nkalan/eecs430-phased-array/EECS430W24_Group7_PCB_BOM.xlsx

Sheet: Full BOM
PN | Description | Designator | Quantity | Manufacturer | Supplier/Source | Link | Unit Cost | Line Cost | Populated
5000 | Red PC Test Point, Miniature Phosphor Bronze Silver Plating Through Hole Mounting Type | TP6, TP7, TP8, TP9, TP10, TP11, TP12, TP13, TP14, TP15, TP16, TP17, TP18 | 13 | Keystone Electronics | Digikey | https://www.digikey.com/en/products/detail/keystone-electronics/5000/255326 | $0.38 | $4.94
OSTVN02A150 | 2 Position Wire to Board Terminal Block Horizontal with Board 0.100" (2.54mm) Through Hole | J3 | 1 | On Shore | Digikey | https://www.digikey.com/en/products/detail/on-shore-technology-inc/OSTVN02A150/1588862 | $1.08 | $1.08
OSTVN03A150 | 3 Position Wire to Board Terminal Block Horizontal with Board 0.100" (2.54mm) Through Hole | J5, J6 | 2 | On Shore | Digikey | https://www.digikey.com/en/products/detail/on-shore-technology-inc/OSTVN03A150/1588863 | $1.23 | $2.46
0732511153 | SMA Connector Jack, Female Socket 50 Ohms Board Edge, End Launch Solder | J1, J2 | 3 | Molex | Digikey | https://www.digikey.com/en/products/detail/molex/0732511153/11305709?s=N4IgTCBcDaIOwGYwFYCM7kJAXQL5A | $3.99 | $11.97
Adafruit_1993 | 2x20 pin Male IDC Box Header - Raspberry Pi A+/B+/Pi 2/Pi 3/Pi 4 | J4 | 1 | Adafruit | Mouser | https://www.mouser.com/ProductDetail/Adafruit/1993?qs=GURawfaeGuBf53f02YlWog%3D%3D | $0.75 | $0.75
Adafruit_1988 | Raspberry Pi Accessories GPIO Ribbon Cable for Raspberry Pi Model A+/B+/Pi 2/Pi 3/Pi 4/5 - (40 pins) | P4 | 1 | Adafruit | Mouser | https://www.mouser.com/ProductDetail/Adafruit/1988?qs=GURawfaeGuA61sDlPzRlbQ%3D%3D | $2.95 | $2.95
APG1005CGC-T | LED GREEN CLEAR CHIP SMD | D1, D2, D3 | 3 | Kingbright | Digikey | https://www.digikey.com/en/products/detail/kingbright/apg1005cgc-t/4764964 | $0.39 | $1.17
n/a | DNP | D4 | 1 | n/a | n/a | n/a | $0.00 | $0.00
KGM15BR71H104KT | 0.1 µF ±10% 50V Ceramic Capacitor X7R 0603 (1608 Metric) | C2, C4, C20 | 3 | Samsung | Digikey | https://www.digikey.com/en/products/detail/kyocera-avx/KGM15BR71H104KT/1600046 | $0.10 | $0.30
CL21B105KBFNNNE | 1 µF ±10% 50V Ceramic Capacitor X7R 0805 (2012 Metric) | C1, C3, C19 | 3 | Samsung | Digikey | https://www.digikey.com/en/products/detail/samsung-electro-mechanics/CL21B105KBFNNNE/3886687 | $0.11 | $0.33
CL31A106KBHNNNE | 10 µF ±10% 50V Ceramic Capacitor X5R 1206 (3216 Metric) | C5 | 1 | Samsung | Digikey | https://www.digikey.com/en/products/detail/samsung-electro-mechanics/cl31a106kbhnnne/3888534 | $0.33 | $0.33
CL-SB-12C-01 | Slide Switch SPDT Through Hole | SW1, SW2 | 2 | Nidec Copal | Digikey | https://www.digikey.com/en/products/detail/nidec-components-corporation/cl-sb-12c-01/3507831 | $1.18 | $2.36
GRM188R72E331KW07D | 330 pF ±10% 250V Ceramic Capacitor X7R 0603 (1608 Metric) | C10, C11, C12 | 3 | Murata | Digikey | https://www.digikey.com/en/products/detail/murata-electronics/grm188r72e331kw07d/789370 | $0.90 | $2.70
GRM1555C1H101JA01 | 100 pF ±5% 50V Ceramic Capacitor C0G, NP0 0402 (1005 Metric) | C6 | 1 | Murata | Digikey | https://www.digikey.com/en/products/detail/murata-electronics/grm1555c1h101ja01d/3693829 | $0.10 | $0.10
GRM155R71H104KE14D | 100nF X7R 0402 ceramic bypass cap | C13.1, C13.2, C14.1, C14.2, C17.1, C17.2, C18.1, C18.2 | 8 | Murata | Digikey | https://www.digikey.com/en/products/detail/murata-electronics/GRM155R71H104KE14D/4906220 | $0.10 | $0.80
GRM1555C1H220JA01 | 22 pF ±5% 50V Ceramic Capacitor C0G, NP0 0402 (1005 Metric) | C7, C8, C15, C16 | 4 | Murata | Digikey | https://www.digikey.com/en/products/detail/murata-electronics/grm1555c1h220ja01d/3175187 | $0.10 | $0.40
HMC407MS8GETR | RF Amplifier IC General Purpose 5GHz ~ 7GHz 8-MSOP-EP | U2 | 1 | Analog Devices | Digikey | https://www.digikey.com/en/products/detail/analog-devices-inc/hmc407ms8getr/3452254 | $18.60 | $18.60
LQG15HS10NJ02D | Multilayer type RF Inductor 10nH ±5% 0.26Ω 500mA 0402 | L1 | 1 | Murata | Digikey | https://www.digikey.com/en/products/detail/murata-electronics/lqg15hs10nj02d/662872 | $0.10 | $0.10
MAPS-010145-TR0500 | Phase Detectors / Shifters 3.5-6.0GHz 4-Bit Step 22.5 deg. | U3.1, U3.2, U5.1, U5.2 | 4 | MACOM | Digikey | https://www.digikey.com/en/products/detail/macom-technology-solutions/MAPS-010145-TR0500/4429760 | $38.70 | $154.80
PE42423B-Z | RF Switch IC 802.11a/b/g/n/ac SPDT 6 GHz 50Ohm 16-QFN (3x3) | U4 | 1 | pSemi | Mouser | https://www.mouser.com/ProductDetail/pSemi/PE42423B-Z?qs=Cb2nCFKsA8oZ1mNDB1JweA%3D%3D | $2.35 | $2.35
PMA3-63GLN+ | RF Amplifier IC LTE, Radar, SATCOM, UMTS, WiFi, WiMAX, WLAN 1.8GHz ~ 6GHz 12-MCLP (3x3) | U1 | 1 | Mini-Circuits | Digikey | https://www.digikey.com/en/products/detail/mini-circuits/pma3-63gln/13927358 | $5.25 | $5.25
RC0603FR-0710KL | 10 kOhms ±1% 0.1W, 1/10W Chip Resistor 0603 (1608 Metric) Moisture Resistant Thick Film | R1, R5 | 2 | Yageo | Digikey | https://www.digikey.com/en/products/detail/yageo/RC0603FR-0710KL/726880 | $0.10 | $0.20
RC0603JR-070RL | 0 Ohms Jumper Chip Resistor 0603 (1608 Metric) Moisture Resistant Thick Film | R2, R3 | 2 | Yageo | Digikey | https://www.digikey.com/en/products/detail/yageo/RC0603JR-070RL/726675 | $0.10 | $0.20
RC0603JR-0722KL | 22 kOhms ±5% 0.1W, 1/10W Chip Resistor 0603 (1608 Metric) Moisture Resistant Thick Film | R4, R6 | 2 | Yageo | Digikey | https://www.digikey.com/en/products/detail/yageo/RC0603JR-0722KL/726744 | $0.10 | $0.20
RC0603JR-07150RL | 150 Ohms ±5% 0.1W, 1/10W Chip Resistor 0603 (1608 Metric) Moisture Resistant Thick Film | R7, R8, R9 | 3 | Yageo | Digikey | https://www.digikey.com/en/products/detail/yageo/RC0603JR-07150RL/726714 | $0.10 | $0.30
n/a | DNP | R10 | 1 | n/a | n/a | n/a | $0.00 | $0.00
TAJA225K016TNJ | 2.2 µF Molded Tantalum Capacitors 16 V 1206 (3216 Metric) 6.5Ohm @ 100kHz | C9 | 1 | Kyocera AVX | Digikey | https://www.digikey.com/en/products/detail/kyocera-avx/taja225k016tnj/11201938 | $0.38 | $0.38
 |  |  |  |  |  |  | Total | $215.02
 |  |  |  |  |  |  | Per array | $208.08

Sheet: Condensed BOM
Component | Cost
SMA Connectors | $11.97
Power Connectors | $3.54
Raspberry PI Connectors | $3.70
Power Amplifier | $18.60
Phase Shifters | $153.16
RF Switch | $2.35
Low Noise Amplifier | $5.25
Miscellaneous Passive Components | $19.00
Total | $217.57
Item | Cost
Components
