nkalan/eecs430-phased-array/EECS430PhasedArray_SCH_PRINT.pdf

# Phase Shifters

# USRP Interface

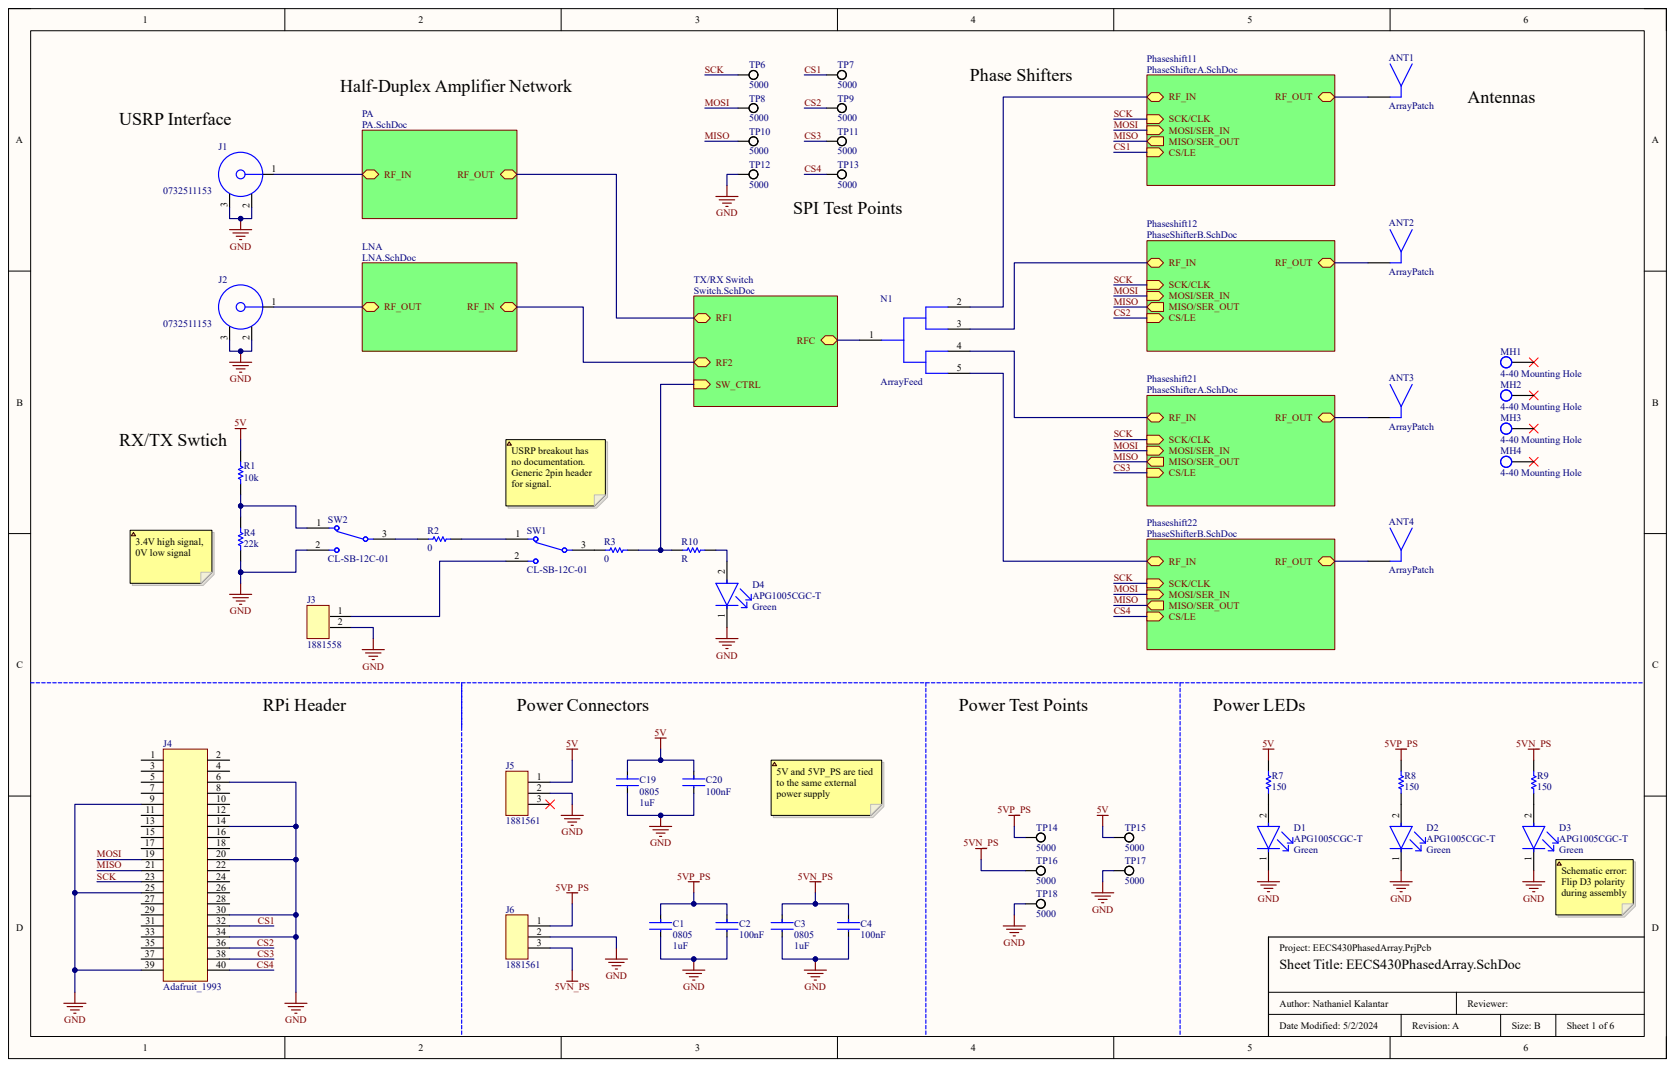
[picture p1: page 1]

Half-Duplex Amplifier Network

5V and 5VP_PS are tied
to the same external
power supply

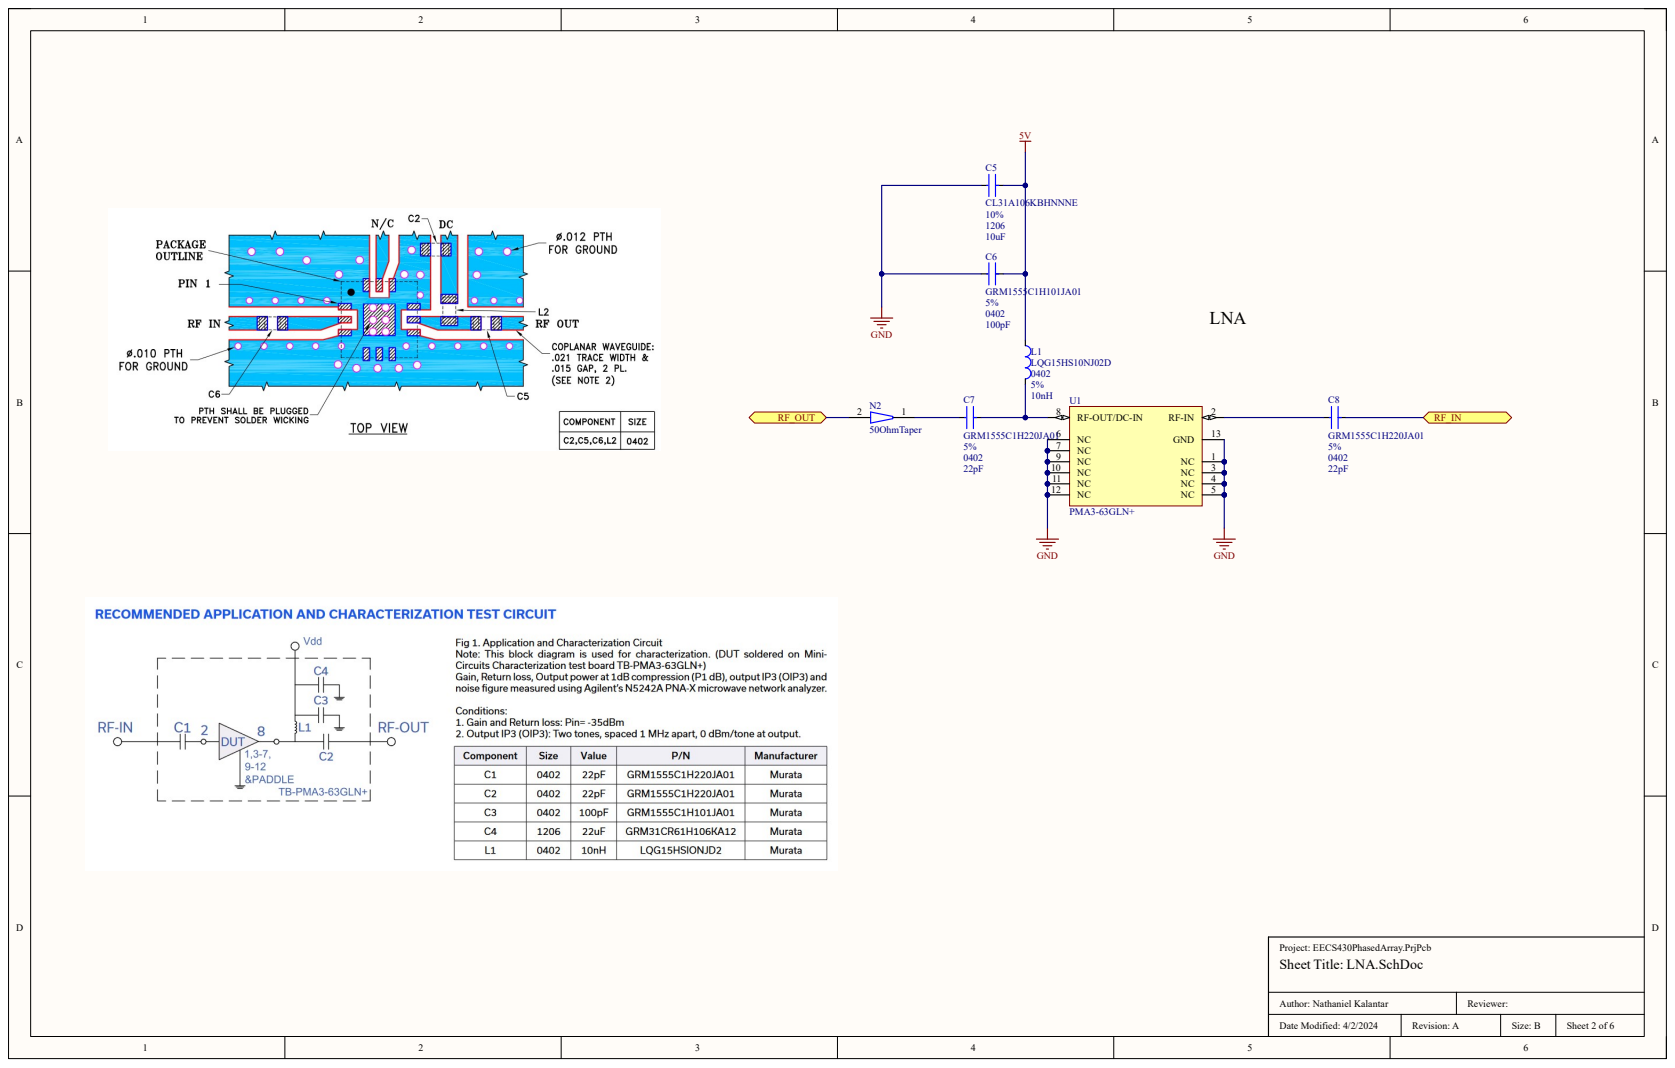
[picture p2: page 2]
Revision: A; Size: B; Sheet 2 of 6; Date Modified: 4/2/2024; GRM1555C1H220JA01; GRM1555C1H101JA01; CL31A106KBHNNNE; RF-OUT/DC-IN 8; GND; PMA3-63GLN+; L1 LQG15HS10NJ02D; LNA; RF_OUT; 50OhmTaper

Project: EECS430PhasedArray.PrjPcb
Sheet Title: LNA.SchDoc

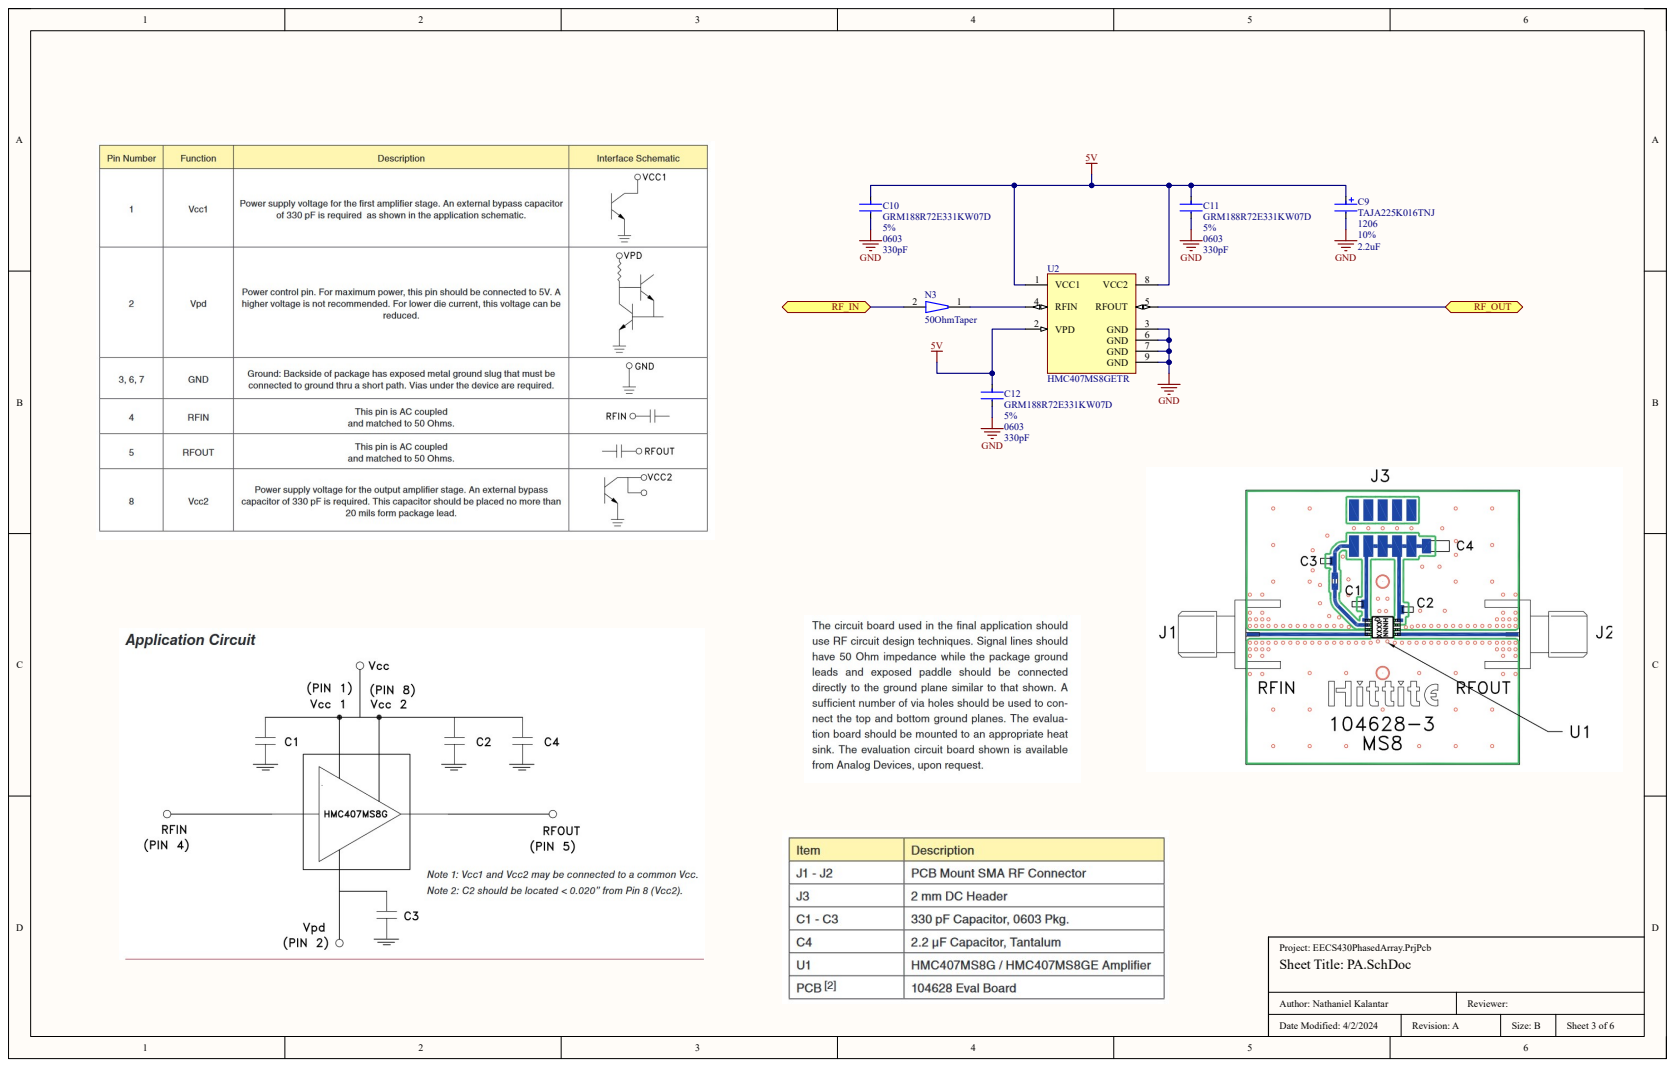
[picture p3: page 3]
Revision: A; Size: B; Sheet 3 of 6; RF_OUT 2; 50OhmTaper; C9 TAJA225K016TNJ; C10 GRM188R72E331KW07D; C11 GRM188R72E331KW07D; C12 GRM188R72E331KW07D; GND; VCC1 1; VPD 2; RFIN 4; RFOUT; VCC2; HMC407MS8GETR

Project: EECS430PhasedArray.PrjPcb
Sheet Title: PA.SchDoc

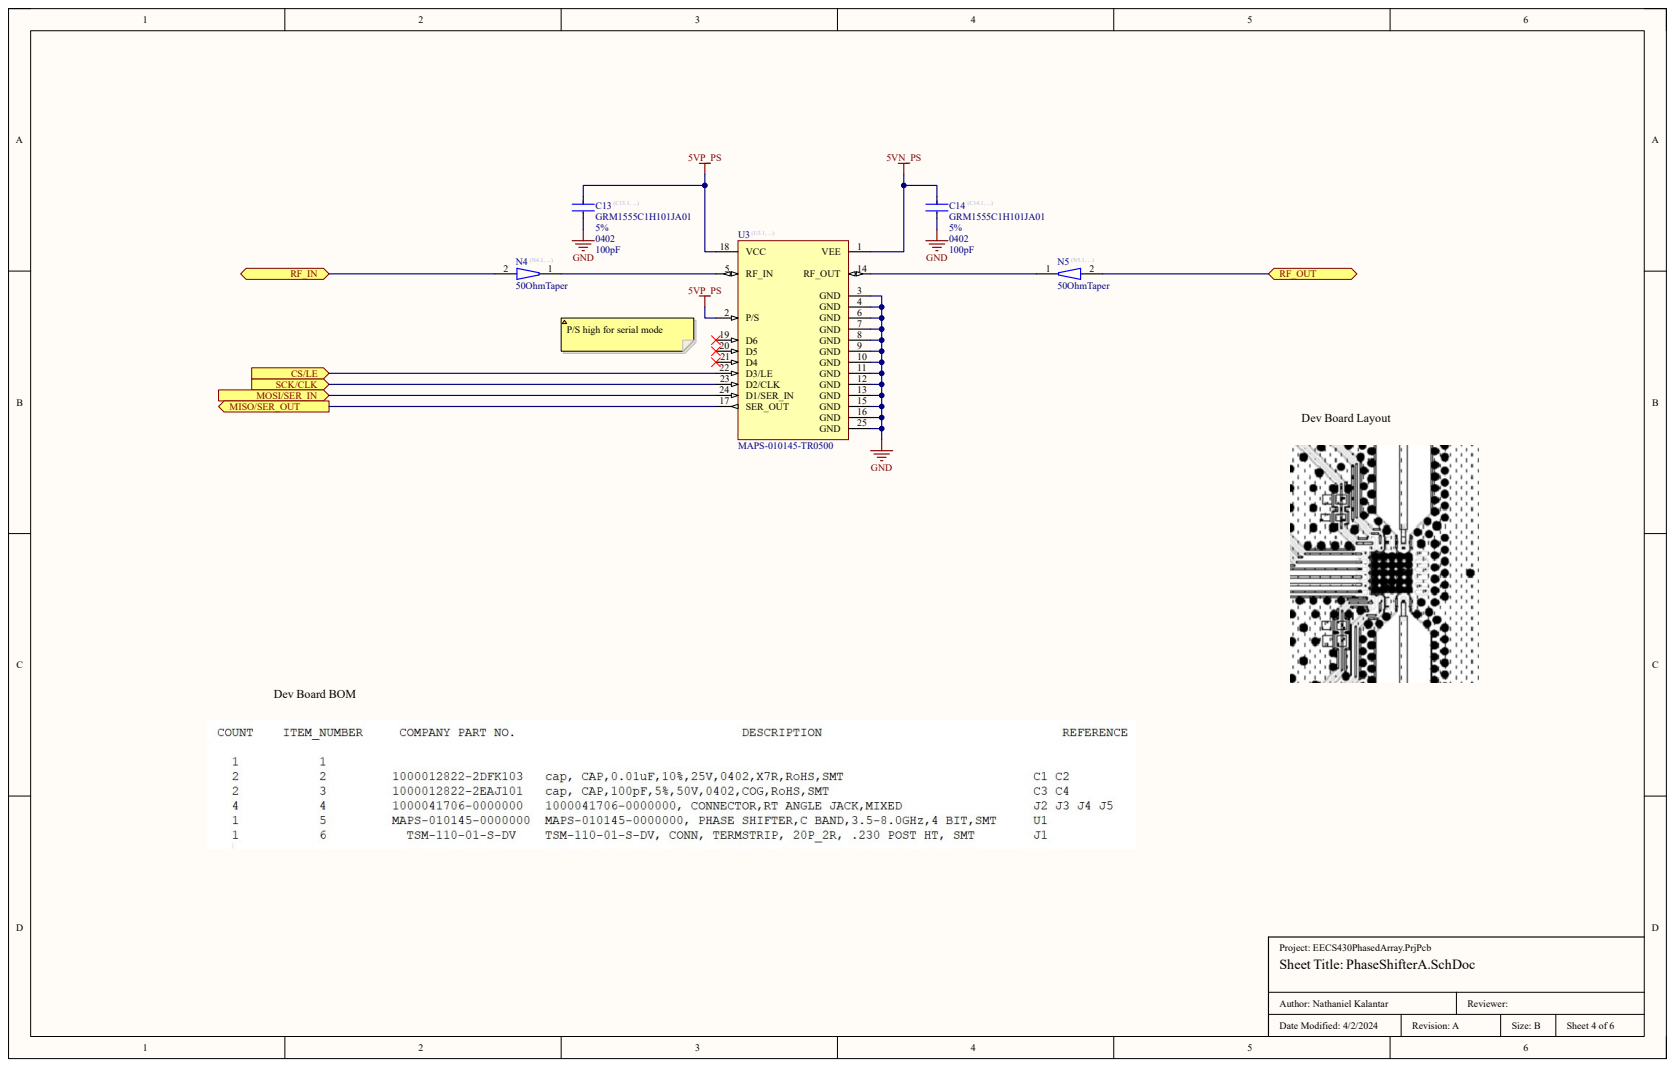
[picture p4: page 4]
Revision: A; Size: B; Sheet 4 of 6; VEE; 1 VCC 18; GND; RF_OUT; SER_OUT 17; D6 19 D5 20 D4 21 D3/LE 22 D2/CLK 23 D1/SER_IN 24; MAPS-010145-TR0500; C14 ⁽C14.1, ...) GRM1555C1H101JA01; C13 ⁽C13.1, ...) GRM1555C1H101JA01; SCK/CLK MOSI/SER_IN MISO/SER_OUT; RF_OUT 2; 50OhmTaper

P/S high for serial mode

Dev Board Layout

Dev Board BOM

Project: EECS430PhasedArray.PrjPcb
Sheet Title: PhaseShifterA.SchDoc

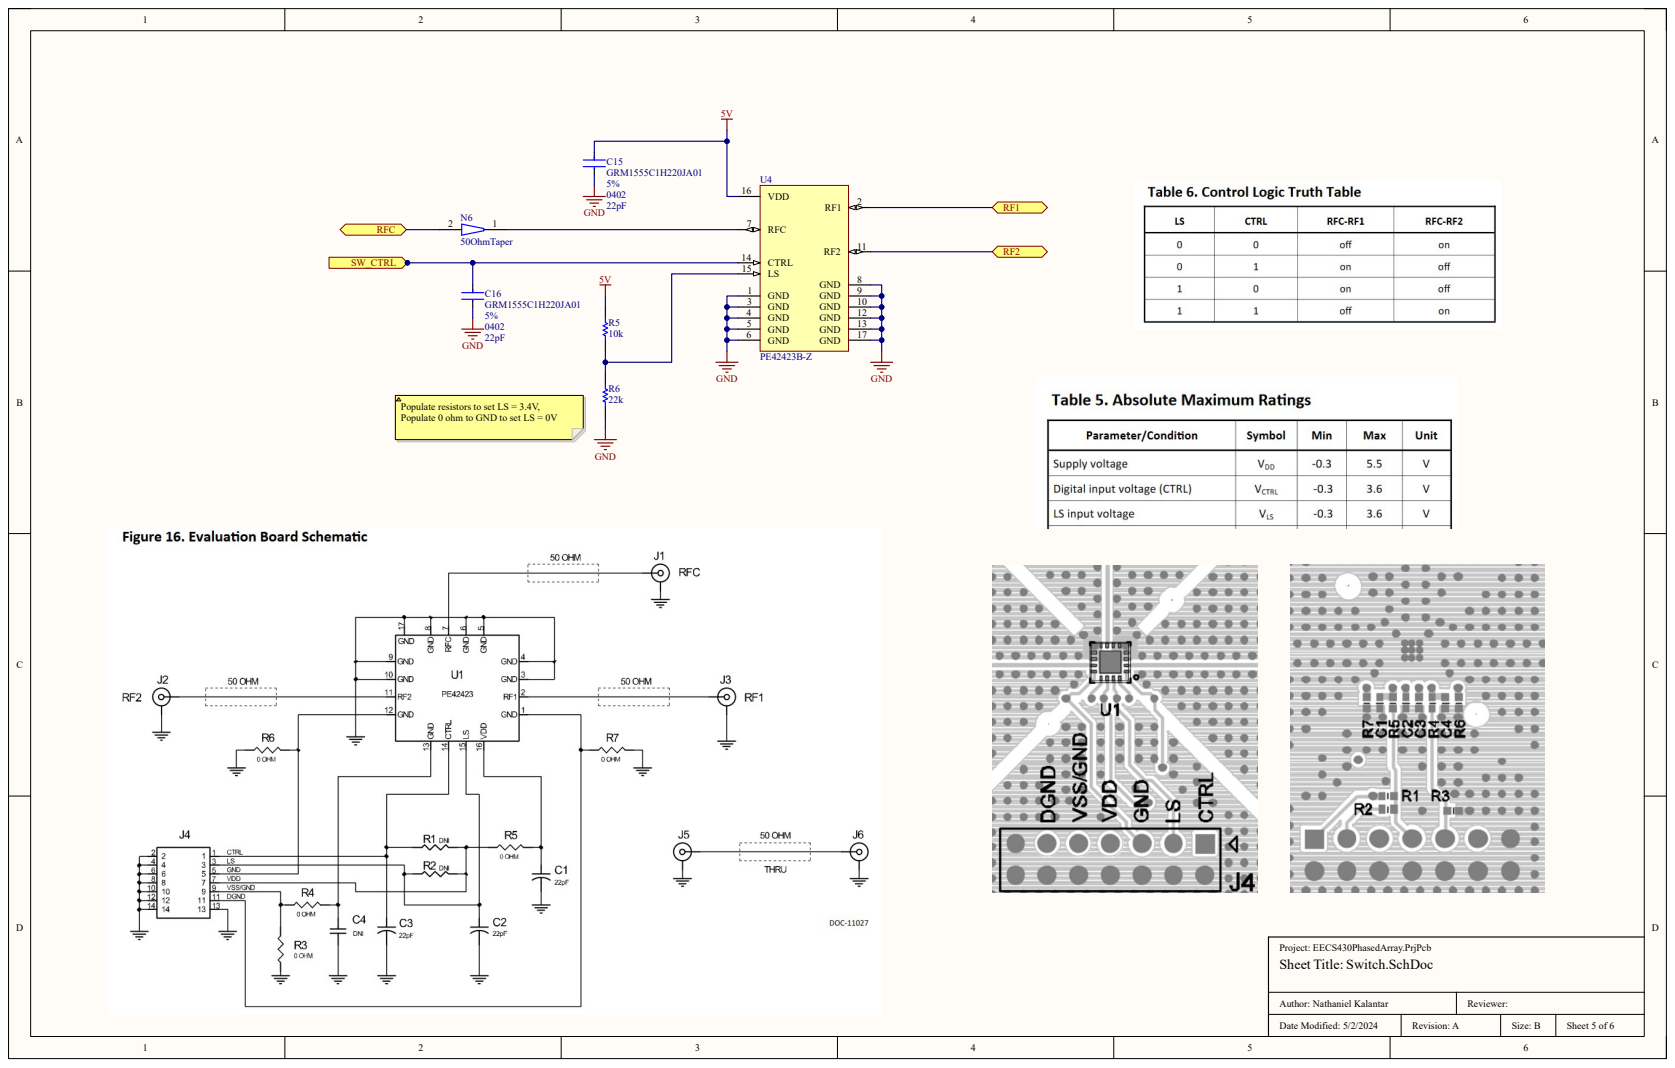
[picture p5: page 5]
Revision: A; Size: B; Sheet 5 of 6; Date Modified: 5/2/2024; GND 1 GND 3 GND 4 GND 5 GND 6; GND; RFC 7; CTRL 14 LS 15; VDD 16; C16 GRM1555C1H220JA01; C15 GRM1555C1H220JA01; RFC; SW_CTRL; 50OhmTaper

Populate resistors to set LS = 3.4V,
Populate 0 ohm to GND to set LS = 0V

Project: EECS430PhasedArray.PrjPcb
Sheet Title: Switch.SchDoc

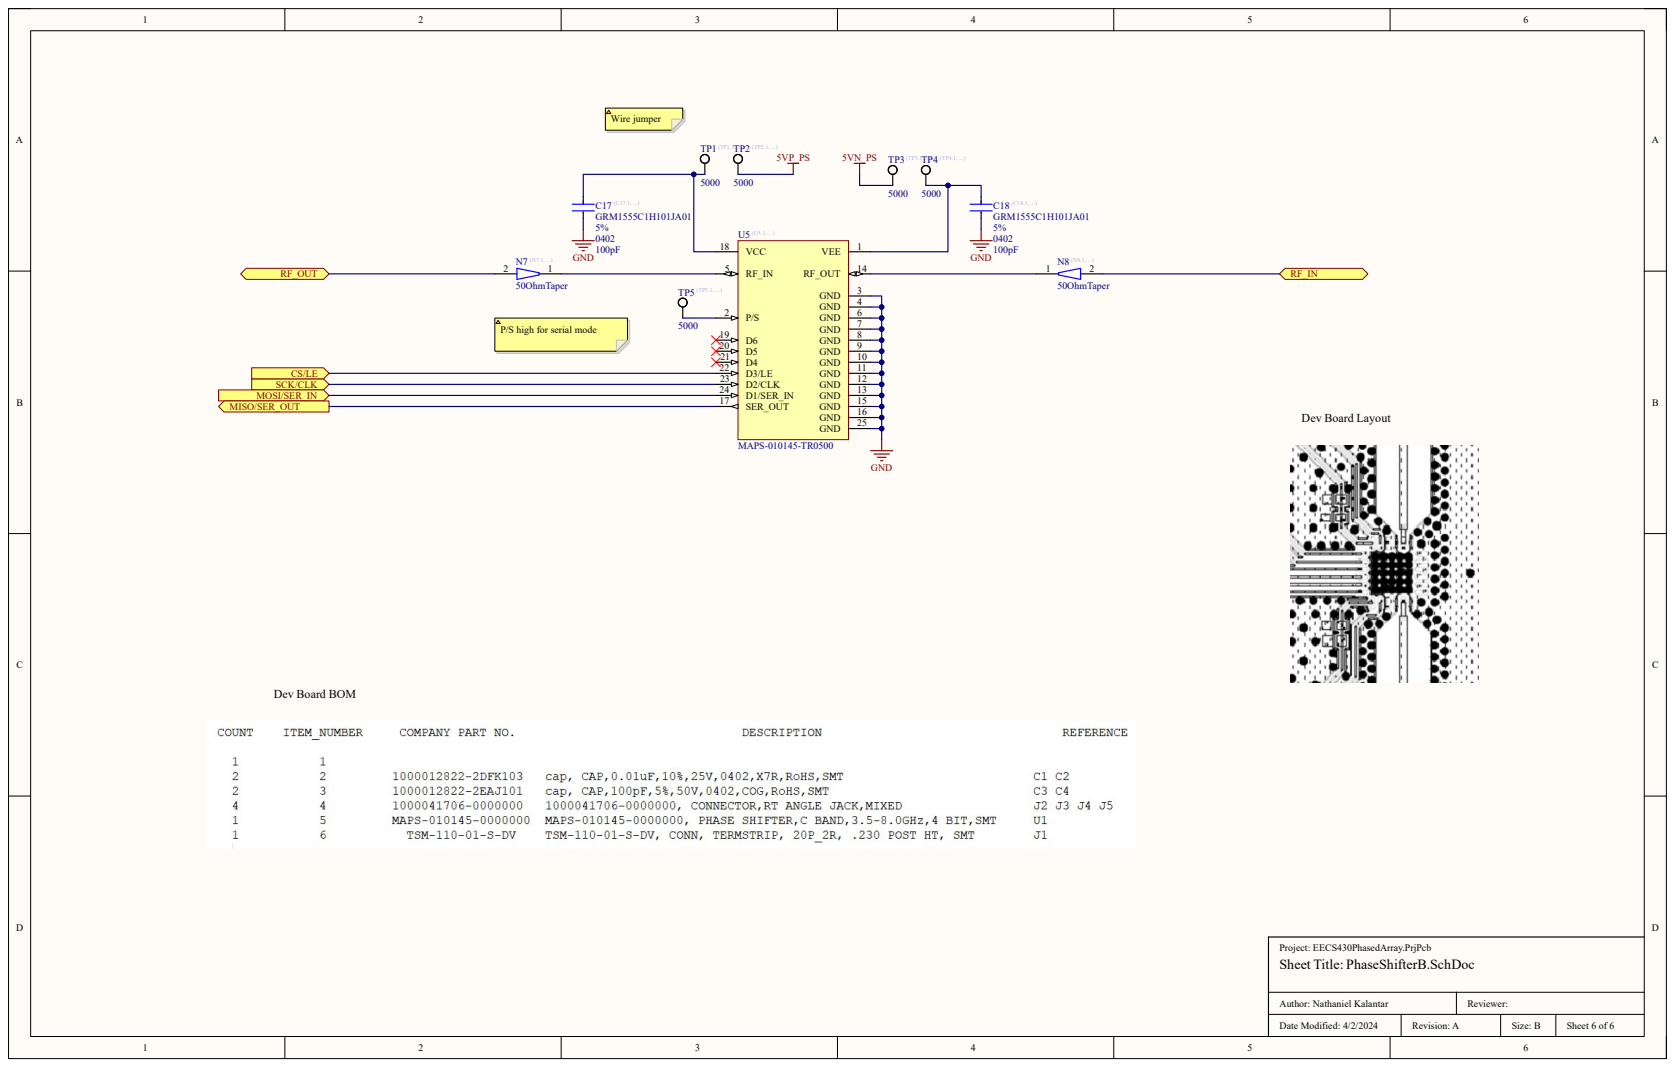
[picture p6: page 6]

5000 P/S high for serial mode

Project: EECS430PhasedArray.PrjPcb
Sheet Title: PhaseShifterB.SchDoc
