nkalan/eecs430-phased-array/EECS430SinglePatch_SCH_PRINT.pdf

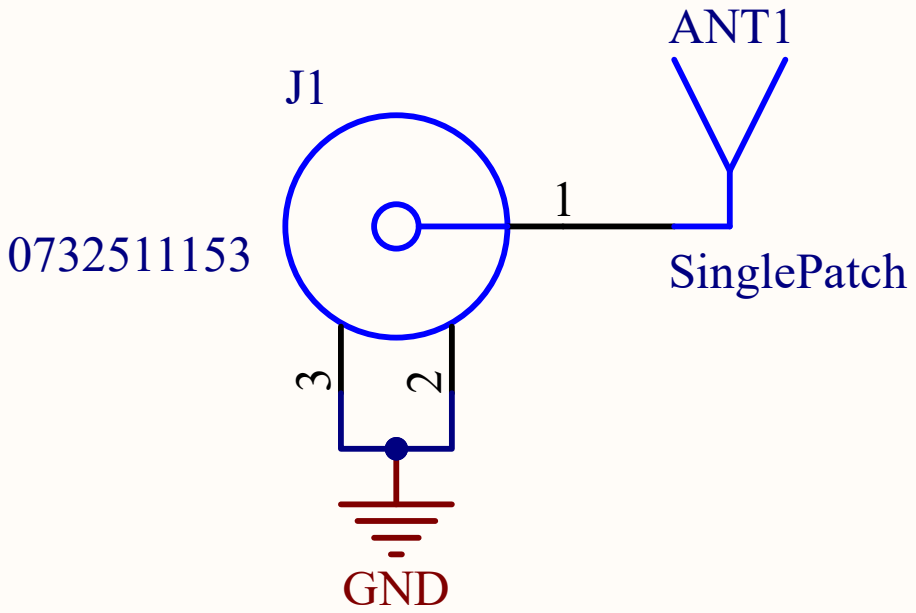
[picture p7: page 1]
Revision:; Size: B; Sheet 1 of 1; Date Modified: 5/2/2024; Author:; Reviewer:; ANT1; SinglePatch; GND

Project: EECS430SinglePatch.PrjPcb
Sheet Title: EECS430SinglePatch.SchDoc
