nkalan/eecs430-phased-array/EECS430PhasedArray/2024-03-25 Schematic Preliminary Printout.pdf

# Phase Shifters USRP Interface

# Half-Duplex Amplifier Network

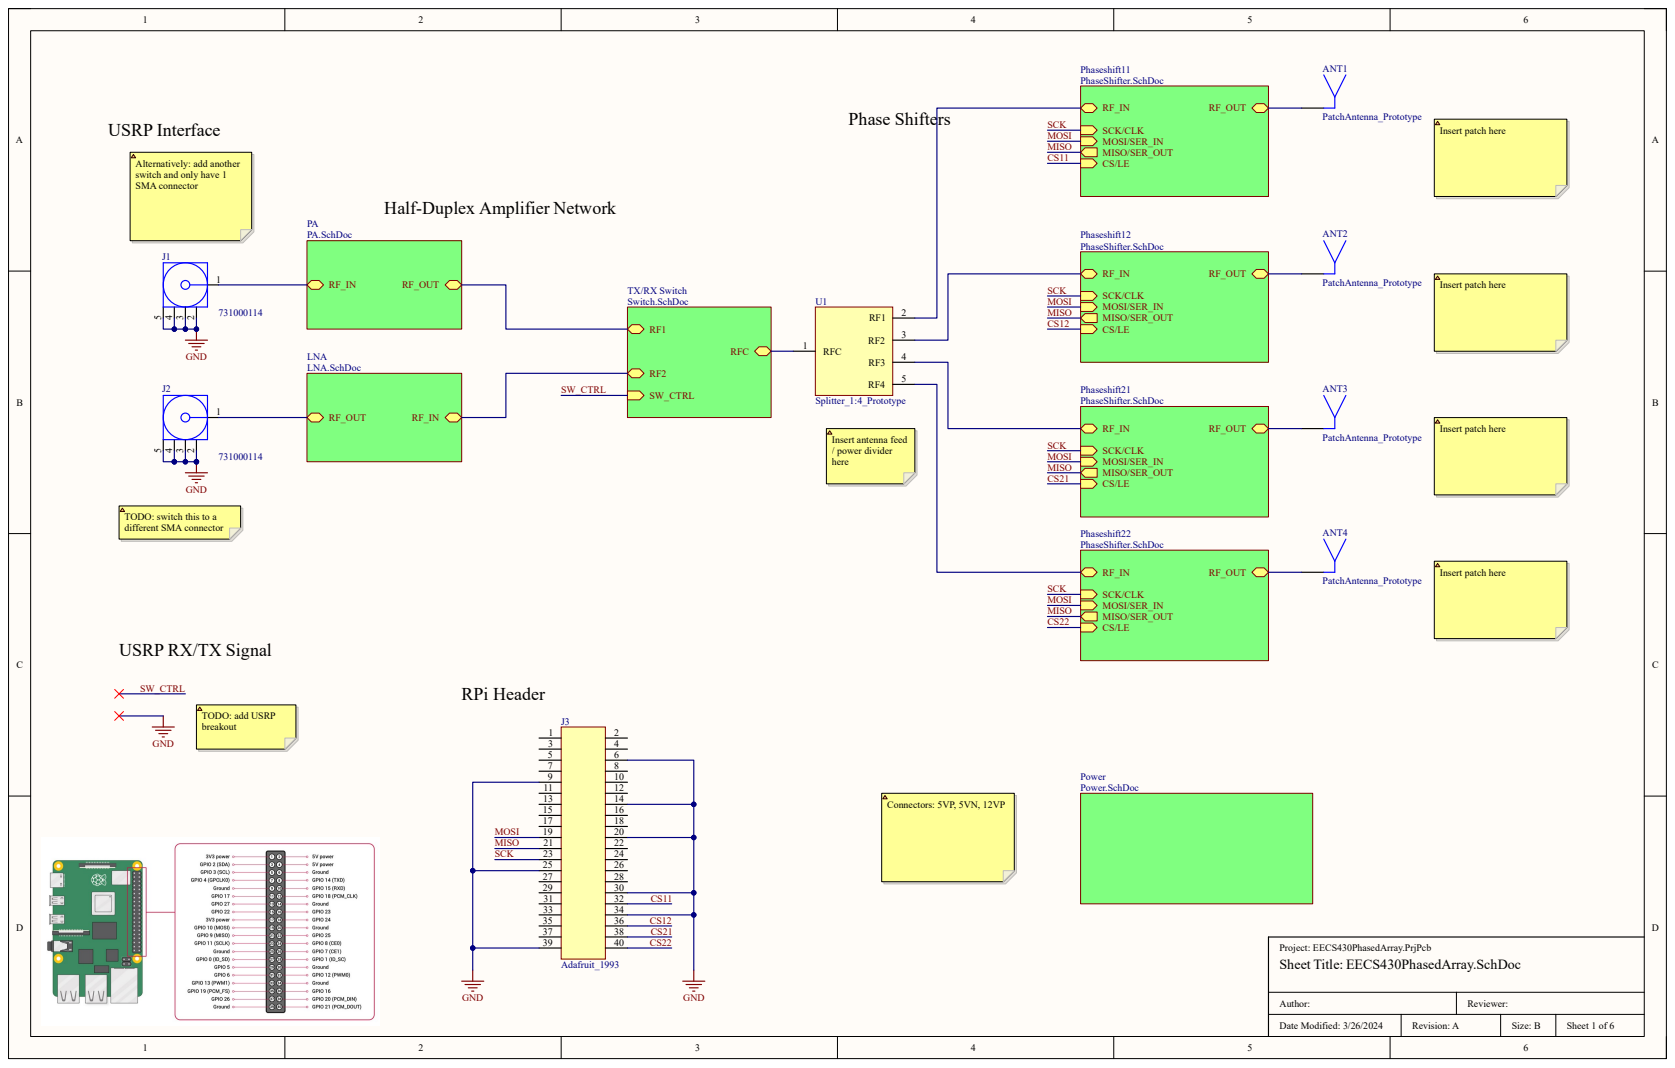
[picture p8: page 1]
Revision: A; Size: B; Sheet 1 of 6; Date Modified: 3/26/2024; Author:; Reviewer:; RF_OUT; LNA LNA.SchDoc; PA PA.SchDoc; RFC; SW_CTRL; SCK/CLK MOSI/SER_IN MISO/SER_OUT CS/LE; Phaseshift11 PhaseShifter.SchDoc; Phaseshift12 PhaseShifter.SchDoc; Phaseshift21 PhaseShifter.SchDoc; Phaseshift22 PhaseShifter.SchDoc; GND; Adafruit_1993; SCK; SCK MOSI; MOSI; MISO; MISO CS11; MOSI MISO; RPi Header; Power Power.SchDoc; RFC 1; Splitter_1:4_Prototype; ANT1; PatchAntenna_Prototype; ANT2; ANT3; ANT4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

Insert patch here

Alternatively: add another
switch and only have 1
SMA connector

TX/RX Switch
Switch.SchDoc

Insert antenna feed
/ power divider
here

TODO: switch this to a
different SMA connector

USRP RX/TX Signal

TODO: add USRP
breakout

Project: EECS430PhasedArray.PrjPcb
Sheet Title: EECS430PhasedArray.SchDoc

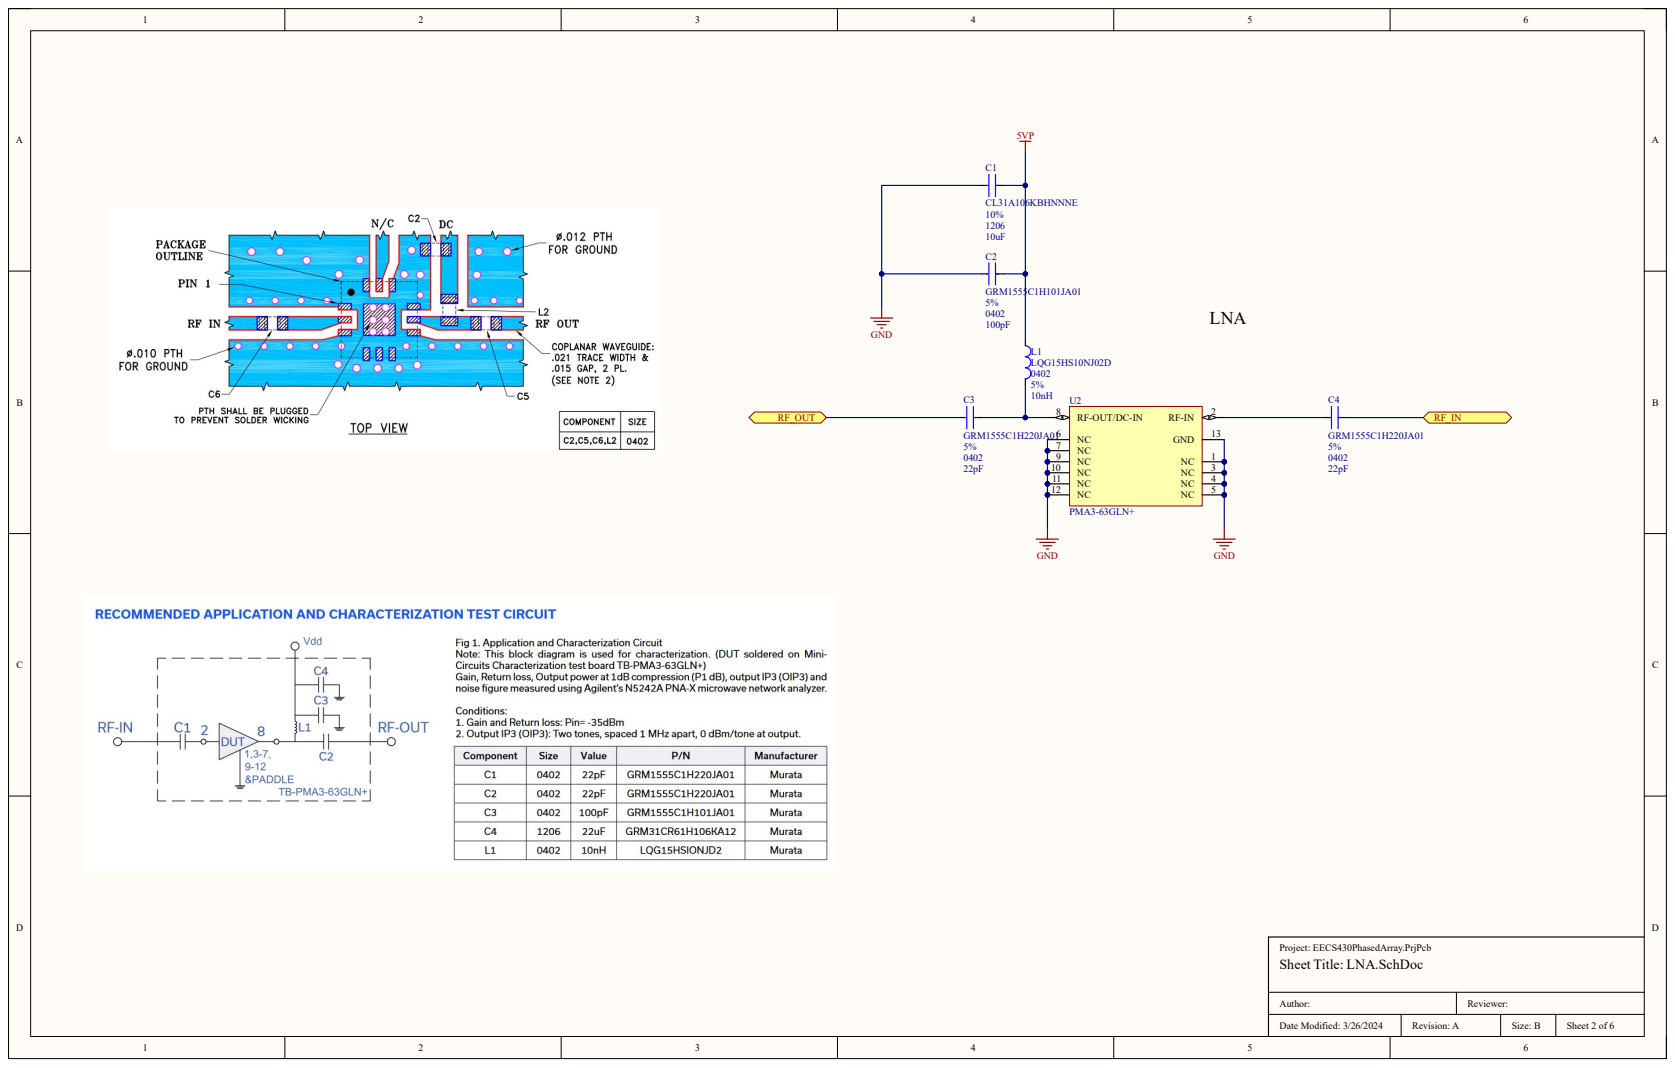
[picture p9: page 2]
Revision: A; Size: B; Sheet 2 of 6; GRM1555C1H220JA01; GRM1555C1H101JA01; CL31A106KBHNNNE; RF-OUT/DC-IN 8; GND; PMA3-63GLN+; L1 LQG15HS10NJ02D; LNA; RF_OUT

Project: EECS430PhasedArray.PrjPcb
Sheet Title: LNA.SchDoc

PA

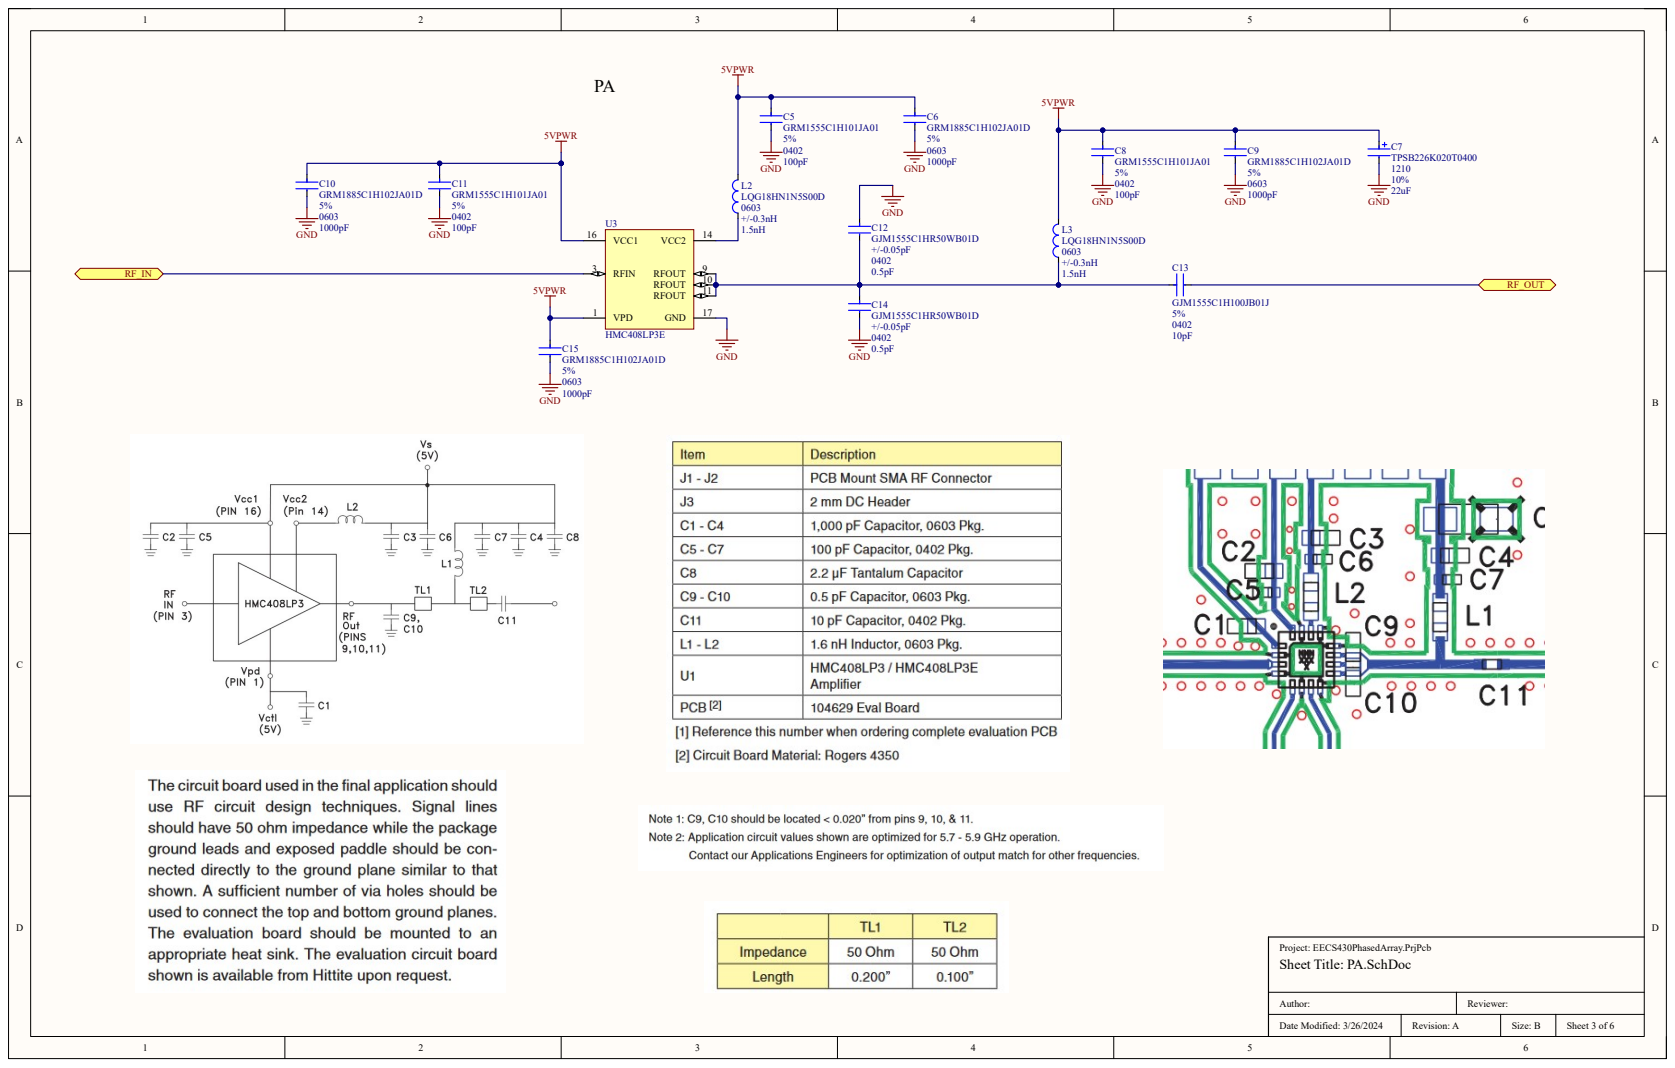
[picture p10: page 3]

Project: EECS430PhasedArray.PrjPcb
Sheet Title: PA.SchDoc

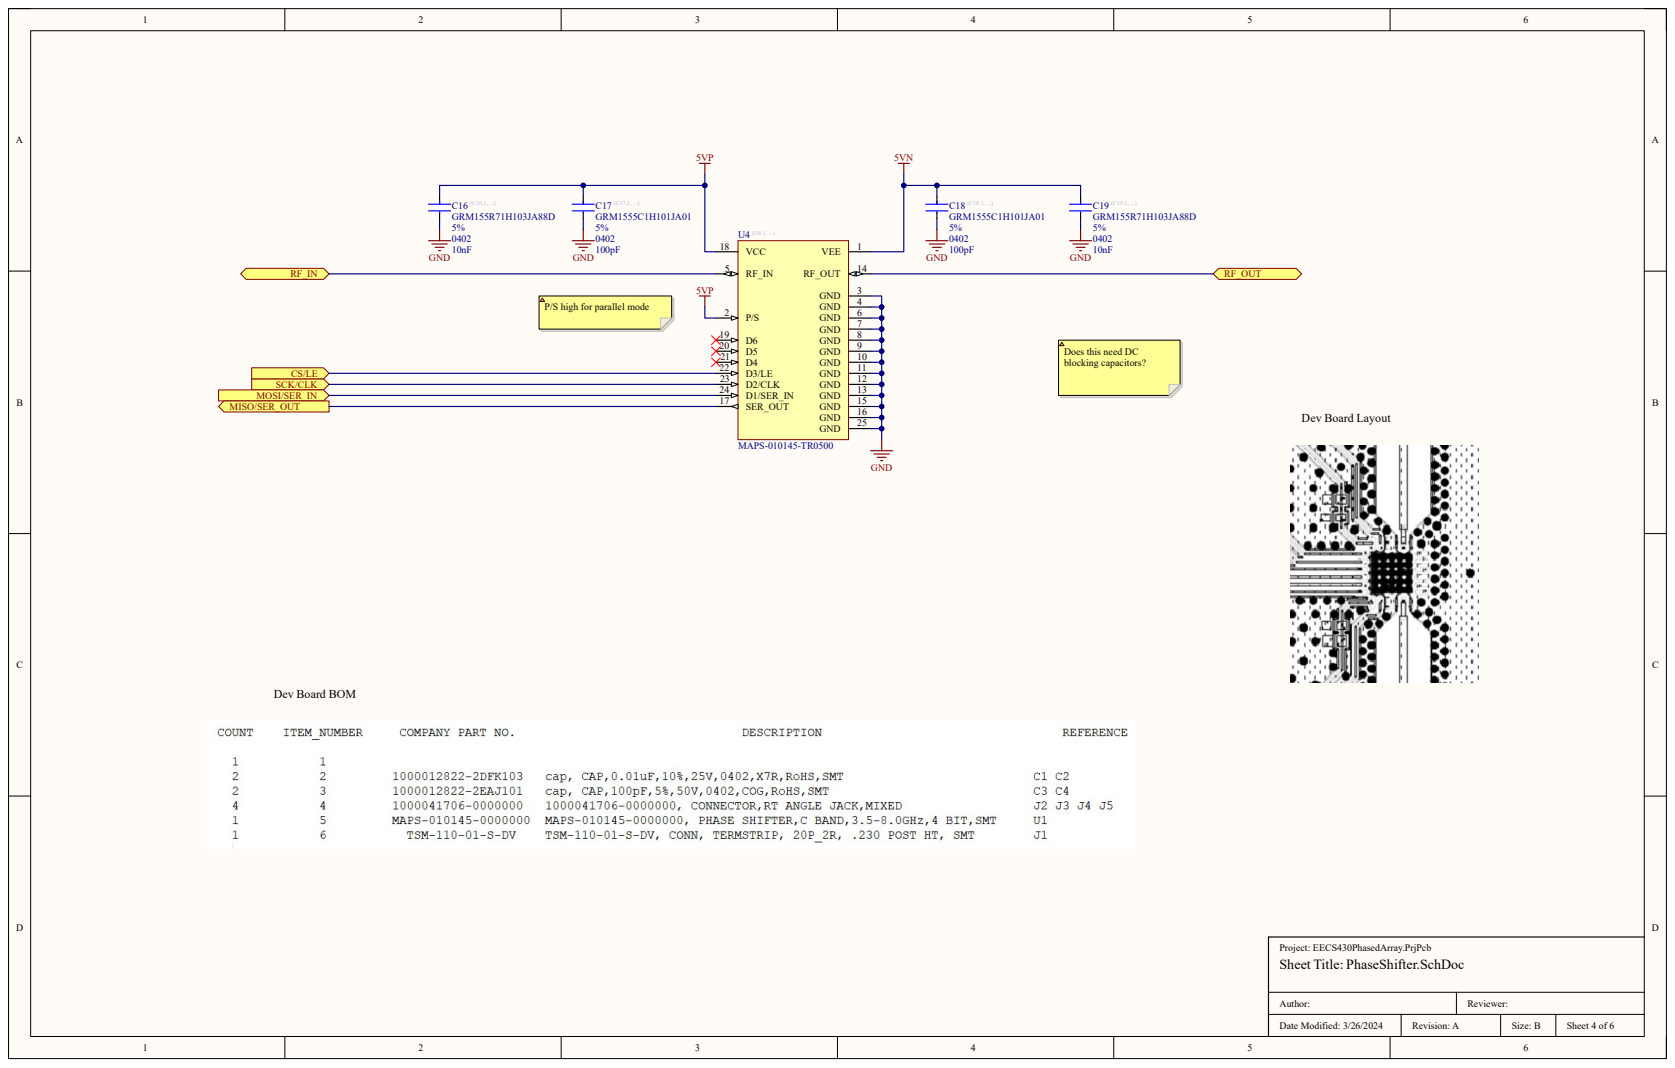
[picture p11: page 4]

P/S high for parallel mode

Does this need DC
blocking capacitors?

Project: EECS430PhasedArray.PrjPcb
Sheet Title: PhaseShifter.SchDoc

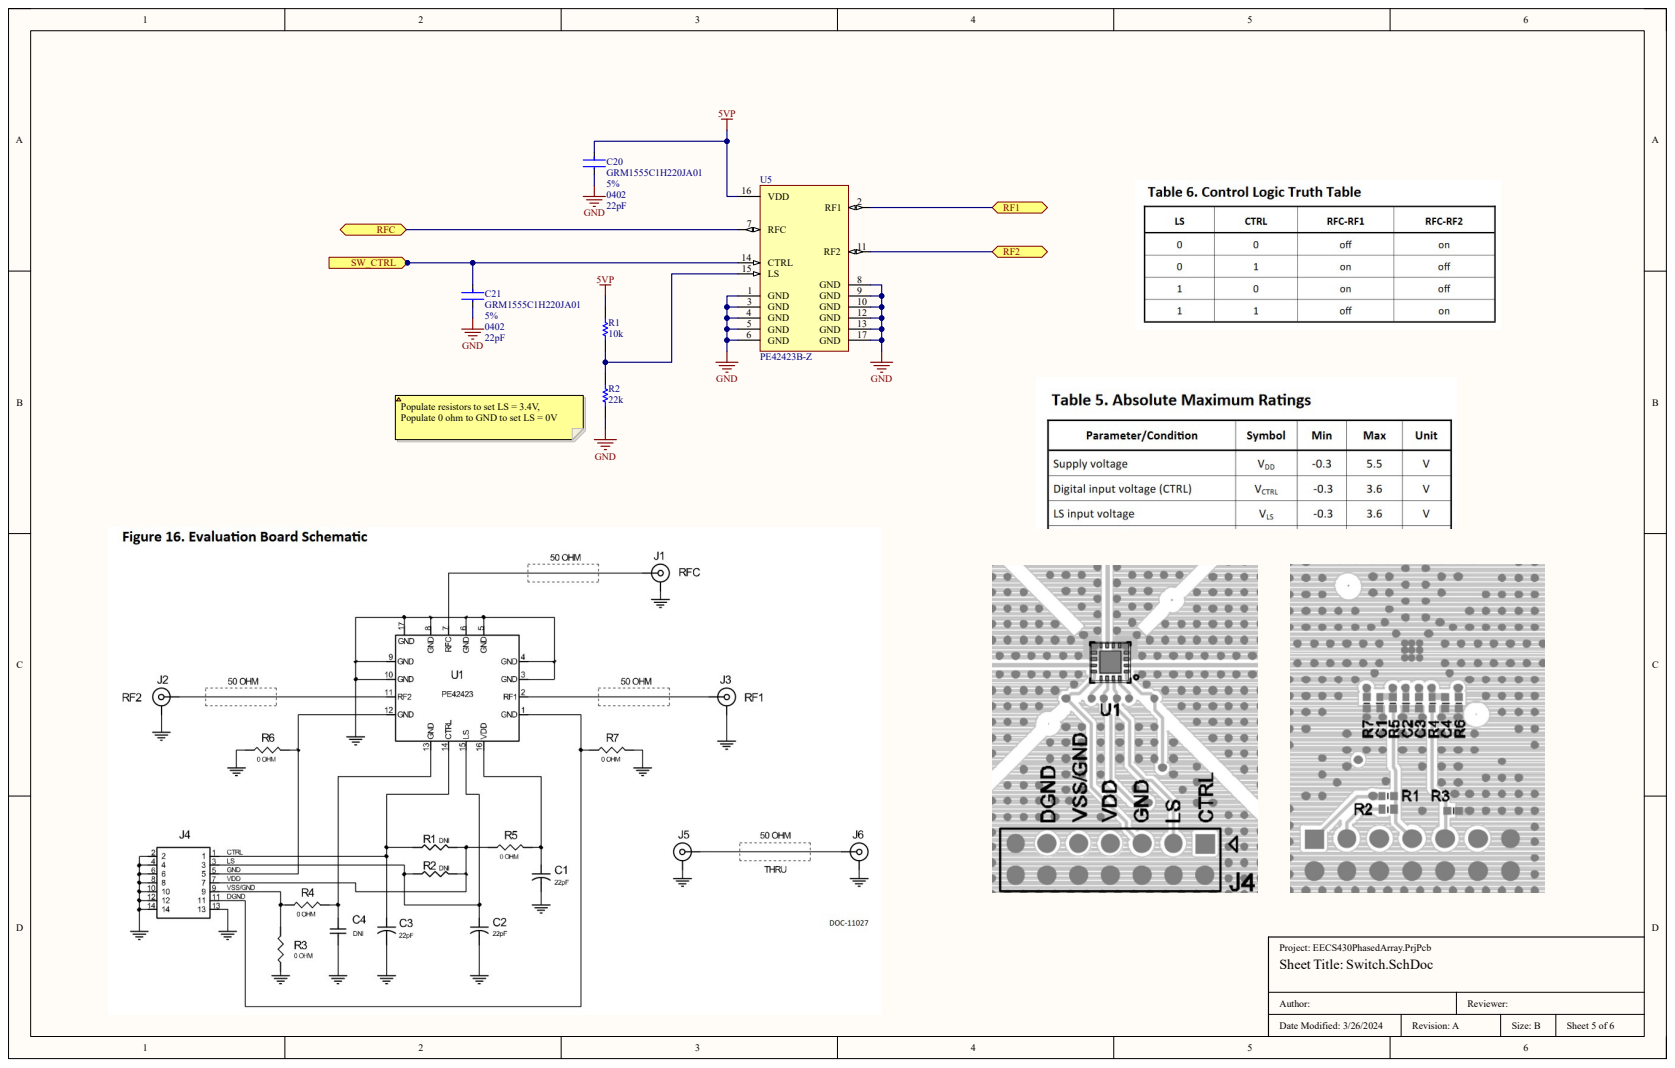
[picture p12: page 5]
Revision: A; Size: B; Sheet 5 of 6; GND 1 GND 3 GND 4 GND 5 GND 6; GND; RFC 7; CTRL 14 LS 15; VDD 16; C21 GRM1555C1H220JA01; C20 GRM1555C1H220JA01; RFC; SW_CTRL

Populate resistors to set LS = 3.4V,
Populate 0 ohm to GND to set LS = 0V

Project: EECS430PhasedArray.PrjPcb
Sheet Title: Switch.SchDoc

D D

C C

B B

A A

Revision: A | Size: B | Sheet 6 of 6

Project: EECS430PhasedArray.PrjPcb

## Sheet Title: Power.SchDoc
