nkalan/eecs430-phased-array/EECS430PhasedArray_PCB_PRINT.pdf

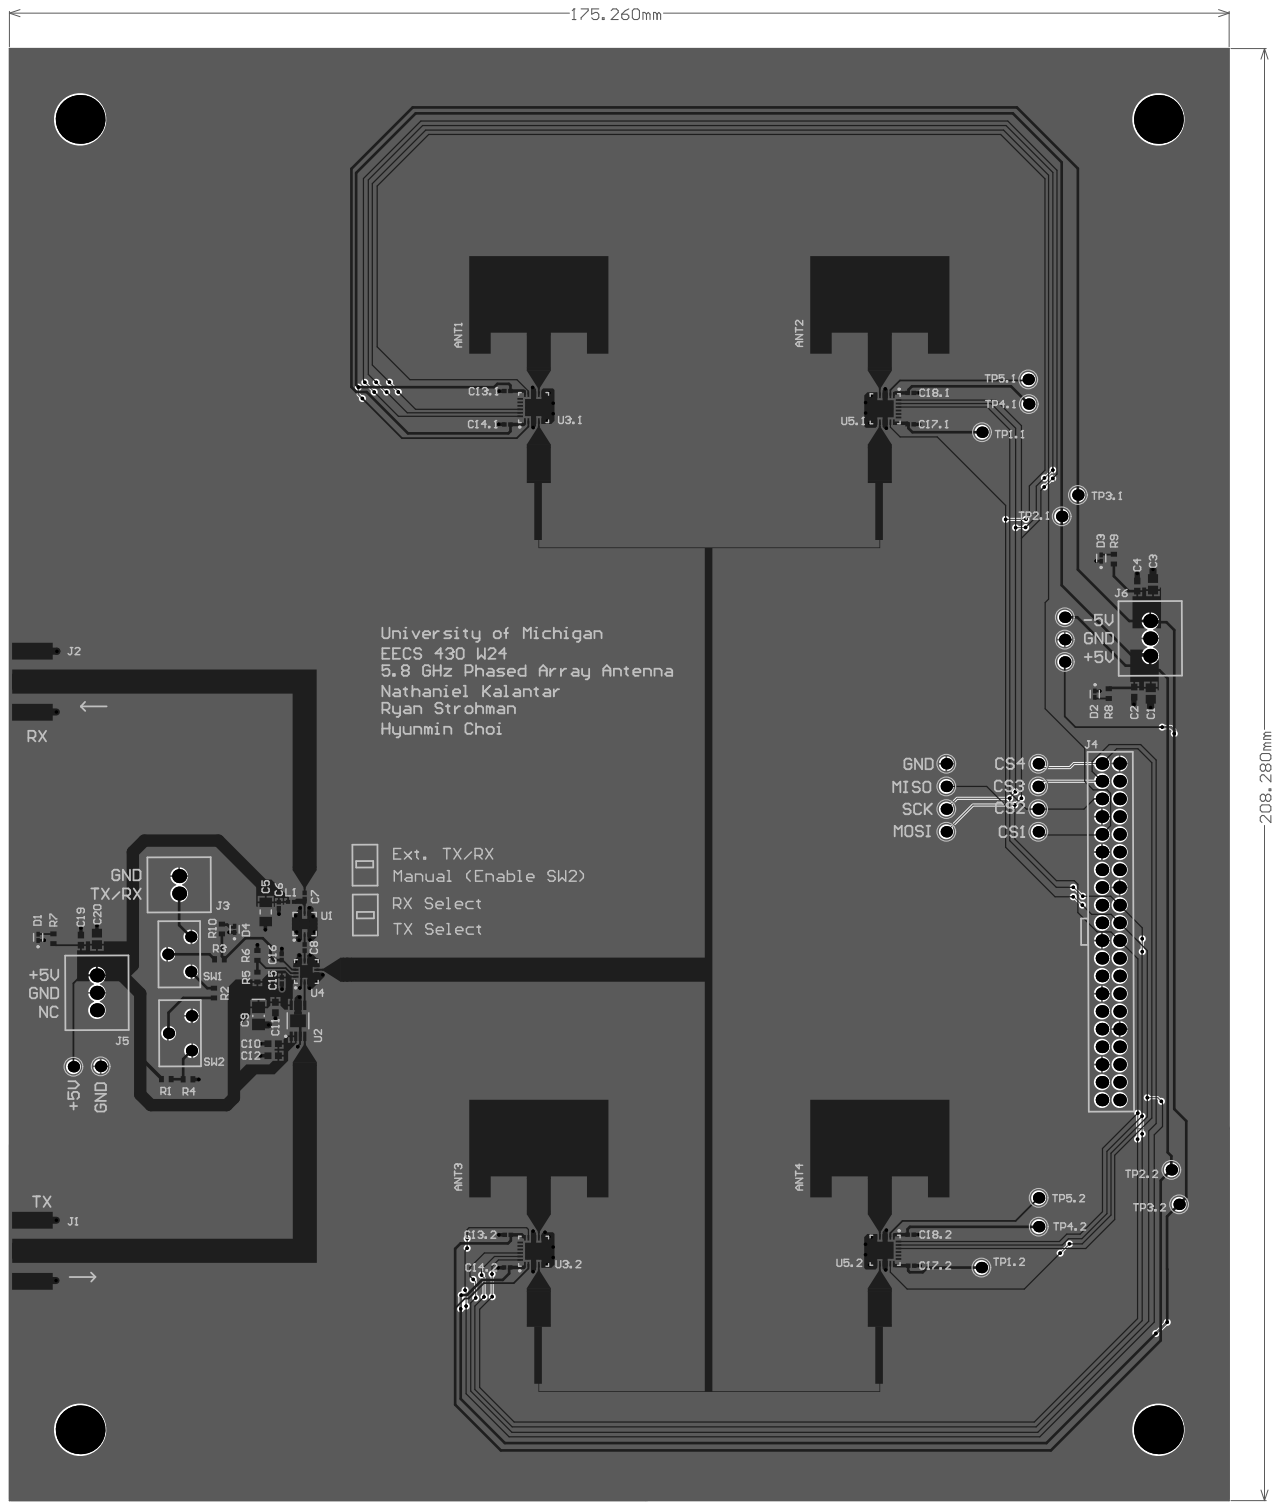
[picture p13: page 1]
