nkalan/eecs430-phased-array/EECS430SinglePatch_PCB_PRINT.pdf

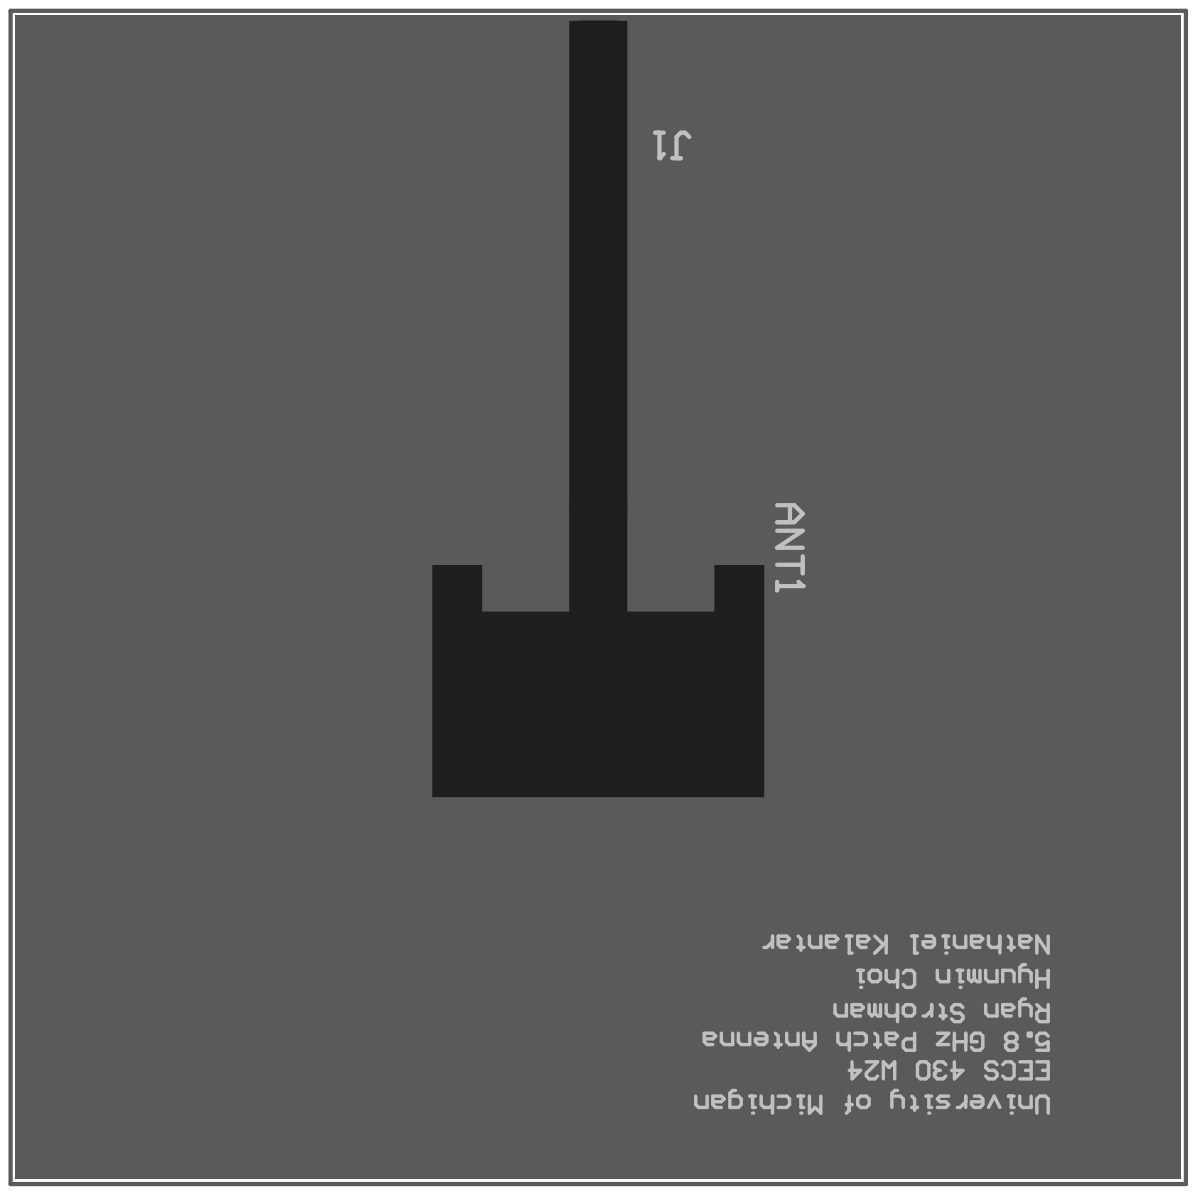
[picture p14: page 1]
