nkalan/eecs430-phased-array/(list of files, drawings)

Other design files:
EECS430PhasedArray/EECS430PhasedArray.PcbDoc
EECS430PhasedArray/EECS430PhasedArray.PcbLib
EECS430PhasedArray/EECS430PhasedArray.PrjPcb
EECS430PhasedArray/EECS430PhasedArray.SchDoc
EECS430PhasedArray/EECS430PhasedArray.SchLib
EECS430PhasedArray/LNA.SchDoc
EECS430PhasedArray/PA.SchDoc
EECS430PhasedArray/PhaseShifterA.SchDoc
EECS430PhasedArray/PhaseShifterB.SchDoc
EECS430PhasedArray/Switch.SchDoc
EECS430SinglePatch/EECS430PhasedArray.PcbLib
EECS430SinglePatch/EECS430PhasedArray.SchLib
EECS430SinglePatch/EECS430SinglePatch.PcbDoc
EECS430SinglePatch/EECS430SinglePatch.PrjPcb
EECS430SinglePatch/EECS430SinglePatch.SchDoc
