nkalan/eecs430-phased-array/(commit log)

2024-03-23 fixed readme, changed template
    [EECS430PhasedArray.SchDoc]
2024-03-25 rolled back repo to remove ltspice sims, replaced altium files with manual backups
    [EECS430PhasedArray.PcbLib, EECS430PhasedArray.PrjPcb, EECS430PhasedArray.SchDoc, EECS430PhasedArray.SchLib, LNA.SchDoc, PA.SchDoc]
2024-03-25 saved file
    [EECS430PhasedArray.SchDoc]
2024-03-26 Added most blocks, TODO power and connectors
    [EECS430PhasedArray.PcbLib, EECS430PhasedArray.PrjPcb, EECS430PhasedArray.SchDoc, EECS430PhasedArray.SchLib, PhaseShifter.SchDoc, Switch.SchDoc]
2024-03-26 Working out kinks in the courtyard and antenna layout
    [EECS430PhasedArray.PcbLib, EECS430PhasedArray.PrjPcb, EECS430PhasedArray.SchDoc, EECS430PhasedArray.SchLib, LNA.SchDoc, PA.SchDoc, PCB1.PcbDoc, PhaseShifter.SchDoc]
2024-03-29 imported feedlines and patches into altium
    [EECS430PhasedArray.PcbLib, EECS430PhasedArray.PrjPcb, EECS430PhasedArray.SchDoc, EECS430PhasedArray.SchLib, Power.SchDoc]
2024-03-29 Renamed pcb file
    [EECS430PhasedArray.PcbDoc, EECS430PhasedArray.PrjPcb, EECS430PhasedArray.SchDoc]
2024-04-01 going all in with the discrete chips, added sma connector and switch
    [EECS430PhasedArray.PcbDoc, EECS430PhasedArray.PcbLib, EECS430PhasedArray.PrjPcb, EECS430PhasedArray.SchDoc, EECS430PhasedArray.SchLib, LNA.SchDoc, PA.SchDoc, PhaseShifter.SchDoc]
2024-04-01 Added connectors, switches, changed PA, doing placement now
    [EECS430PhasedArray.PcbDoc, EECS430PhasedArray.PcbLib, EECS430PhasedArray.PrjPcb, EECS430PhasedArray.SchDoc, EECS430PhasedArray.SchLib, LNA.SchDoc, PA.SchDoc, PhaseShifter.SchDoc]
2024-04-01 Adding mirrored phase shifter
    [EECS430PhasedArray.PcbDoc, EECS430PhasedArray.PcbLib, EECS430PhasedArray.PrjPcb, EECS430PhasedArray.SchDoc, LNA.SchDoc, PA.SchDoc, PhaseShifter.SchDoc, PhaseShifterA.SchDoc]
2024-04-02 Passed DRC, added test points, LEDs, labels
    [EECS430PhasedArray.PcbDoc, EECS430PhasedArray.PcbLib, EECS430PhasedArray.SchDoc, LNA.SchDoc, PA.SchDoc, PhaseShifterA.SchDoc, PhaseShifterB.SchDoc, Switch.SchDoc]
2024-04-02 saving before stretching array
    [EECS430PhasedArray.GBL, EECS430PhasedArray.GBO, EECS430PhasedArray.GBP, EECS430PhasedArray.GBS, EECS430PhasedArray.GTL, EECS430PhasedArray.GTO, EECS430PhasedArray.GTP, EECS430PhasedArray.GTS]
2024-04-02 stretched feed again, saving
    [EECS430PhasedArray.PcbDoc, EECS430PhasedArray.PcbLib, EECS430PhasedArray.PrjPcb]
2024-04-02 Saving again, extending by 2mm
    [EECS430PhasedArray.PcbDoc, EECS430PhasedArray.PcbLib, EECS430PhasedArray.SchDoc, EECS430PhasedArray.SchLib]
2024-04-02 Finished updating dimensions, passes DRC
    [EECS430PhasedArray.PcbDoc]
2024-04-03 covered up pads on net ties
    [EECS430PhasedArray.GBL, EECS430PhasedArray.GBO, EECS430PhasedArray.GBP, EECS430PhasedArray.GBS, EECS430PhasedArray.GTL, EECS430PhasedArray.GTO, EECS430PhasedArray.GTP, EECS430PhasedArray.GTS]
2024-04-04 made single patch project, ordered boards, need to order parts now
    [BOM.xlsx, EECS430PhasedArray.PcbDoc, EECS430PhasedArray.PcbLib, EECS430PhasedArray.SchLib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]
2024-04-08 sent out for fab, finished BOM
    [BOM.xlsx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]
2024-05-02 Final commit, fixed silkscreen labels
    [EECS430PhasedArray.PcbDoc, EECS430PhasedArray.PcbLib, EECS430PhasedArray.SchDoc, EECS430W24_Group7_PCB_BOM.xlsx, Switch.SchDoc]
2024-05-02 Printed out schematic and layout pdfs, fixed BOM
    [EECS430PhasedArray.PcbDoc, EECS430PhasedArray.SchDoc, EECS430SinglePatch.PcbDoc, EECS430SinglePatch.SchDoc, EECS430W24_Group7_PCB_BOM.xlsx]
2024-05-02 switched phase shifter link to digikey
    [EECS430W24_Group7_PCB_BOM.xlsx]
2024-05-02 Copied final gerbers to top level folder
